ojaroker/OJAquaFlux/(commit log)

2026-03-09 K30 Relay Control
2026-03-09 Formatting, removing duplicates, K30 relay control
2026-03-09 Clean up printing
2026-03-22 need to fix actuator control and rename bubbletrap.ino
    [AQUA_Flux_Colgate.ino]
2026-03-22 diagnostic message and rename chamber
2026-03-22 log error on rtc failure
    [setupLogging.ino]
2026-03-22 Replaced #if blocks with DEBUG_PRINT to reduce clutter
    [AQUA_Flux_Colgate.ino, setupActuator.ino, setupK30.ino, setupLogging.ino, setupSht85.ino]
2026-03-23 refactored chamber.ino into a statemachine to represent actuator
2026-03-23 refactored xbee commands, updated readme and moved actuator pulse timing into constants
2026-03-23 compiler error "type" fixed by changing to headers
    [AQUA_Flux_Colgate.ino, chamber.h]
2026-03-23 Robustness after I2C bus lockup. Reload the date after I2C stabilizes
2026-03-24 Improved logging robustness to handle I2C lockups. Added additional xbee control options.
2026-03-24 bug fixes, additonal xbee controls
    [AQUA_Flux_Colgate.ino, printConfig.ino, setRtcDate.ino, xbeeCommands.ino]
2026-03-25 sd card not writing fix and integrity check
    [setupLogging.ino, testSdCard.ino]
2026-03-26 pin change
2026-03-26 Move error handling to separate file; prepare to refactor k30
    [error.ino, setupLogging.ino]
2026-03-26 Setup error handling for K30 address and error check
    [setupK30.ino]
2026-03-26 refactor relay control into separate file
2026-03-27 debug .. flushing wire
2026-03-27 time for i2c to stabilize
    [recoverI2CBus.ino]
